JQIamo/digital-buffer-box/Schematic_rev3.pdf

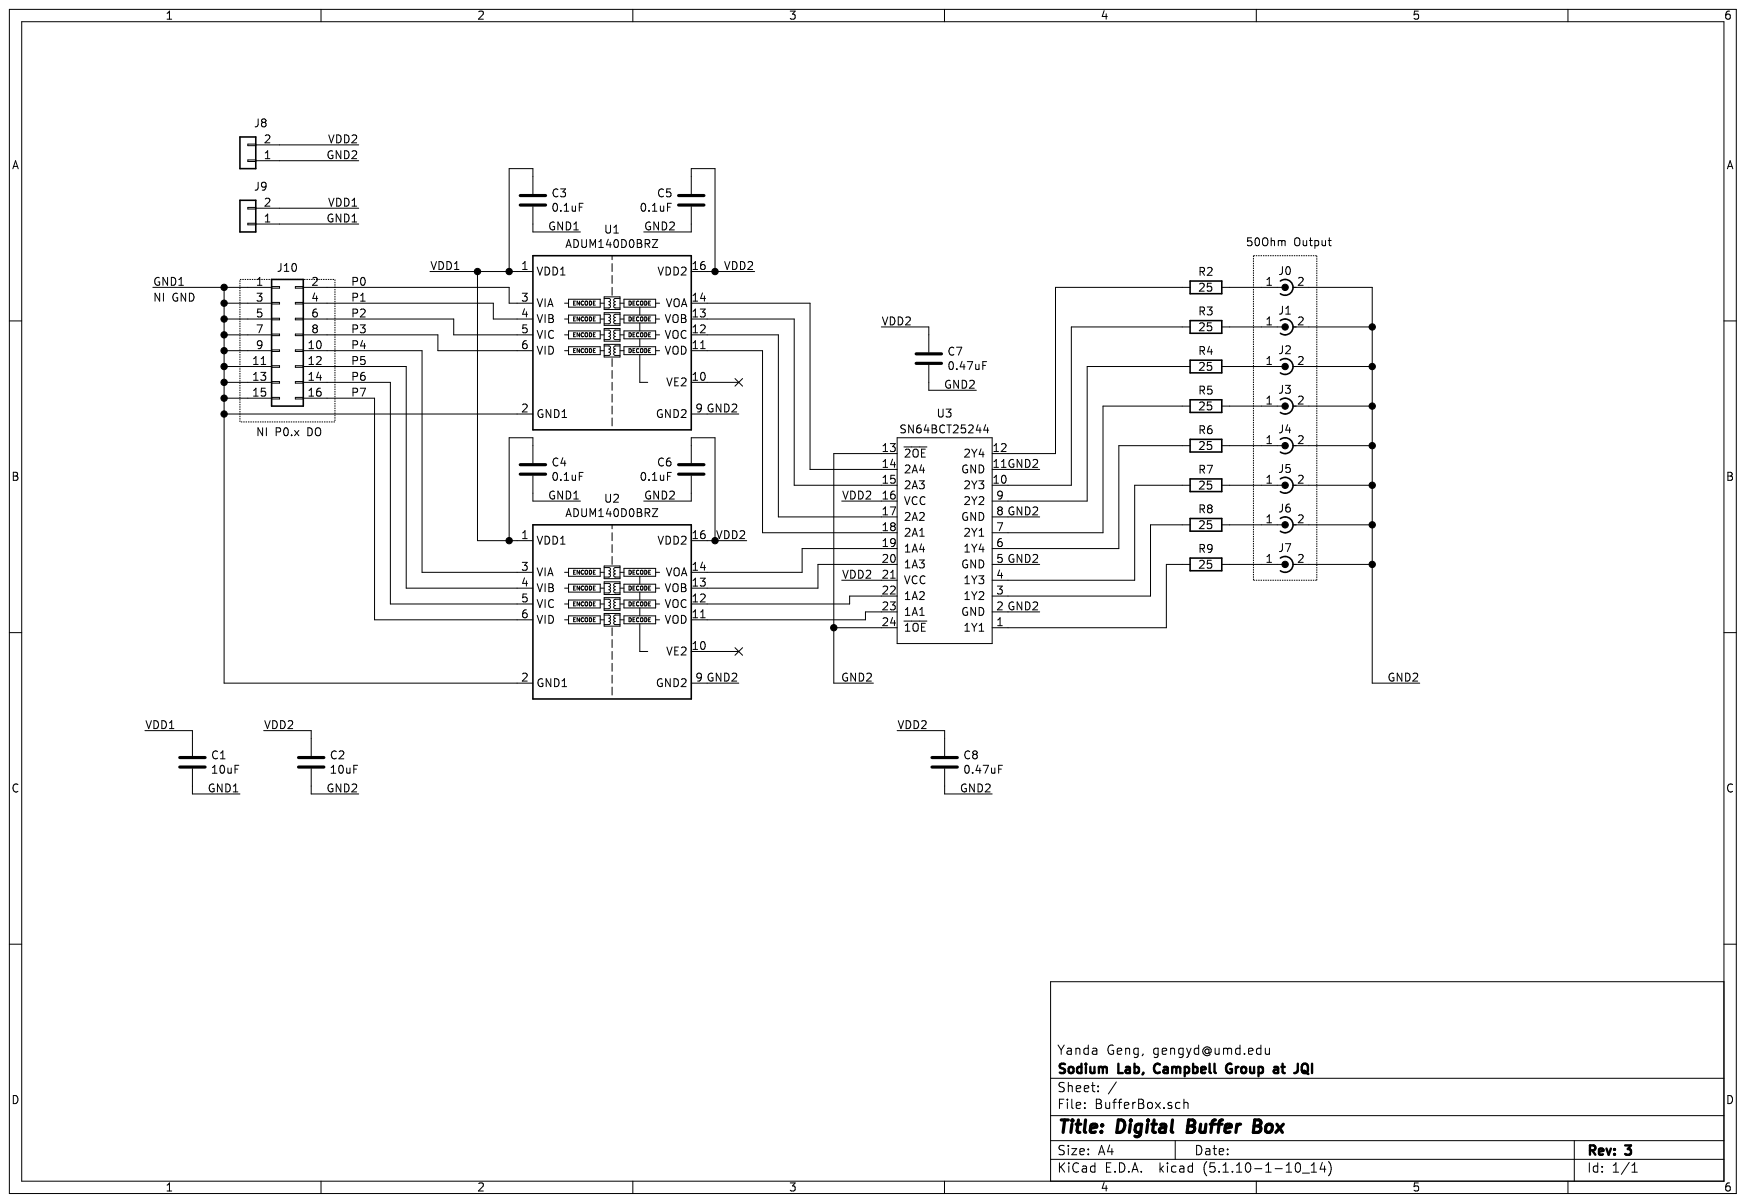
[picture p1: page 1]
