JQIamo/digital-buffer-box/(commit log)

2021-10-06 init commit
    [BufferBox.csv, BufferBox.kicad_pcb, BufferBox.sch]
2021-10-06 added gerber files
    [BufferBox-B_Cu.gbr, BufferBox-B_Mask.gbr, BufferBox-B_SilkS.gbr, BufferBox-Edge_Cuts.gbr, BufferBox-F_Cu.gbr, BufferBox-F_Mask.gbr, BufferBox-F_SilkS.gbr, BufferBox-NPTH.drl]
2021-10-07 add via fence
    [BufferBox-B_Cu.gbr, BufferBox-B_Mask.gbr, BufferBox-B_SilkS.gbr, BufferBox-Edge_Cuts.gbr, BufferBox-F_Cu.gbr, BufferBox-F_Paste.gbr, BufferBox-F_SilkS.gbr, BufferBox-NPTH.drl]
2021-10-07 Via fence suggestion
    [BufferBox.kicad_pcb]
2021-10-07 fixed DRC issues
    [BufferBox-B_Cu.gbr, BufferBox-B_Mask.gbr, BufferBox-B_SilkS.gbr, BufferBox-Edge_Cuts.gbr, BufferBox-F_Cu.gbr, BufferBox-F_Mask.gbr, BufferBox-F_Paste.gbr, BufferBox-F_SilkS.gbr]
2021-10-08 redo via fences
    [BufferBox-B_Cu.gbr, BufferBox-B_Mask.gbr, BufferBox-B_SilkS.gbr, BufferBox-Edge_Cuts.gbr, BufferBox-F_Cu.gbr, BufferBox-F_Mask.gbr, BufferBox-F_Paste.gbr, BufferBox-F_SilkS.gbr]
2021-10-08 fixed margin
    [BufferBox-B_Cu.gbr, BufferBox-B_Mask.gbr, BufferBox-B_SilkS.gbr, BufferBox-Edge_Cuts.gbr, BufferBox-F_Cu.gbr, BufferBox-F_Mask.gbr, BufferBox-F_Paste.gbr, BufferBox-F_SilkS.gbr]
2021-10-21 fix front panel hole size
